volium/prelude/prelude.kicad_pcb

## KiCad design prelude.kicad_pcb (2019-05-13)

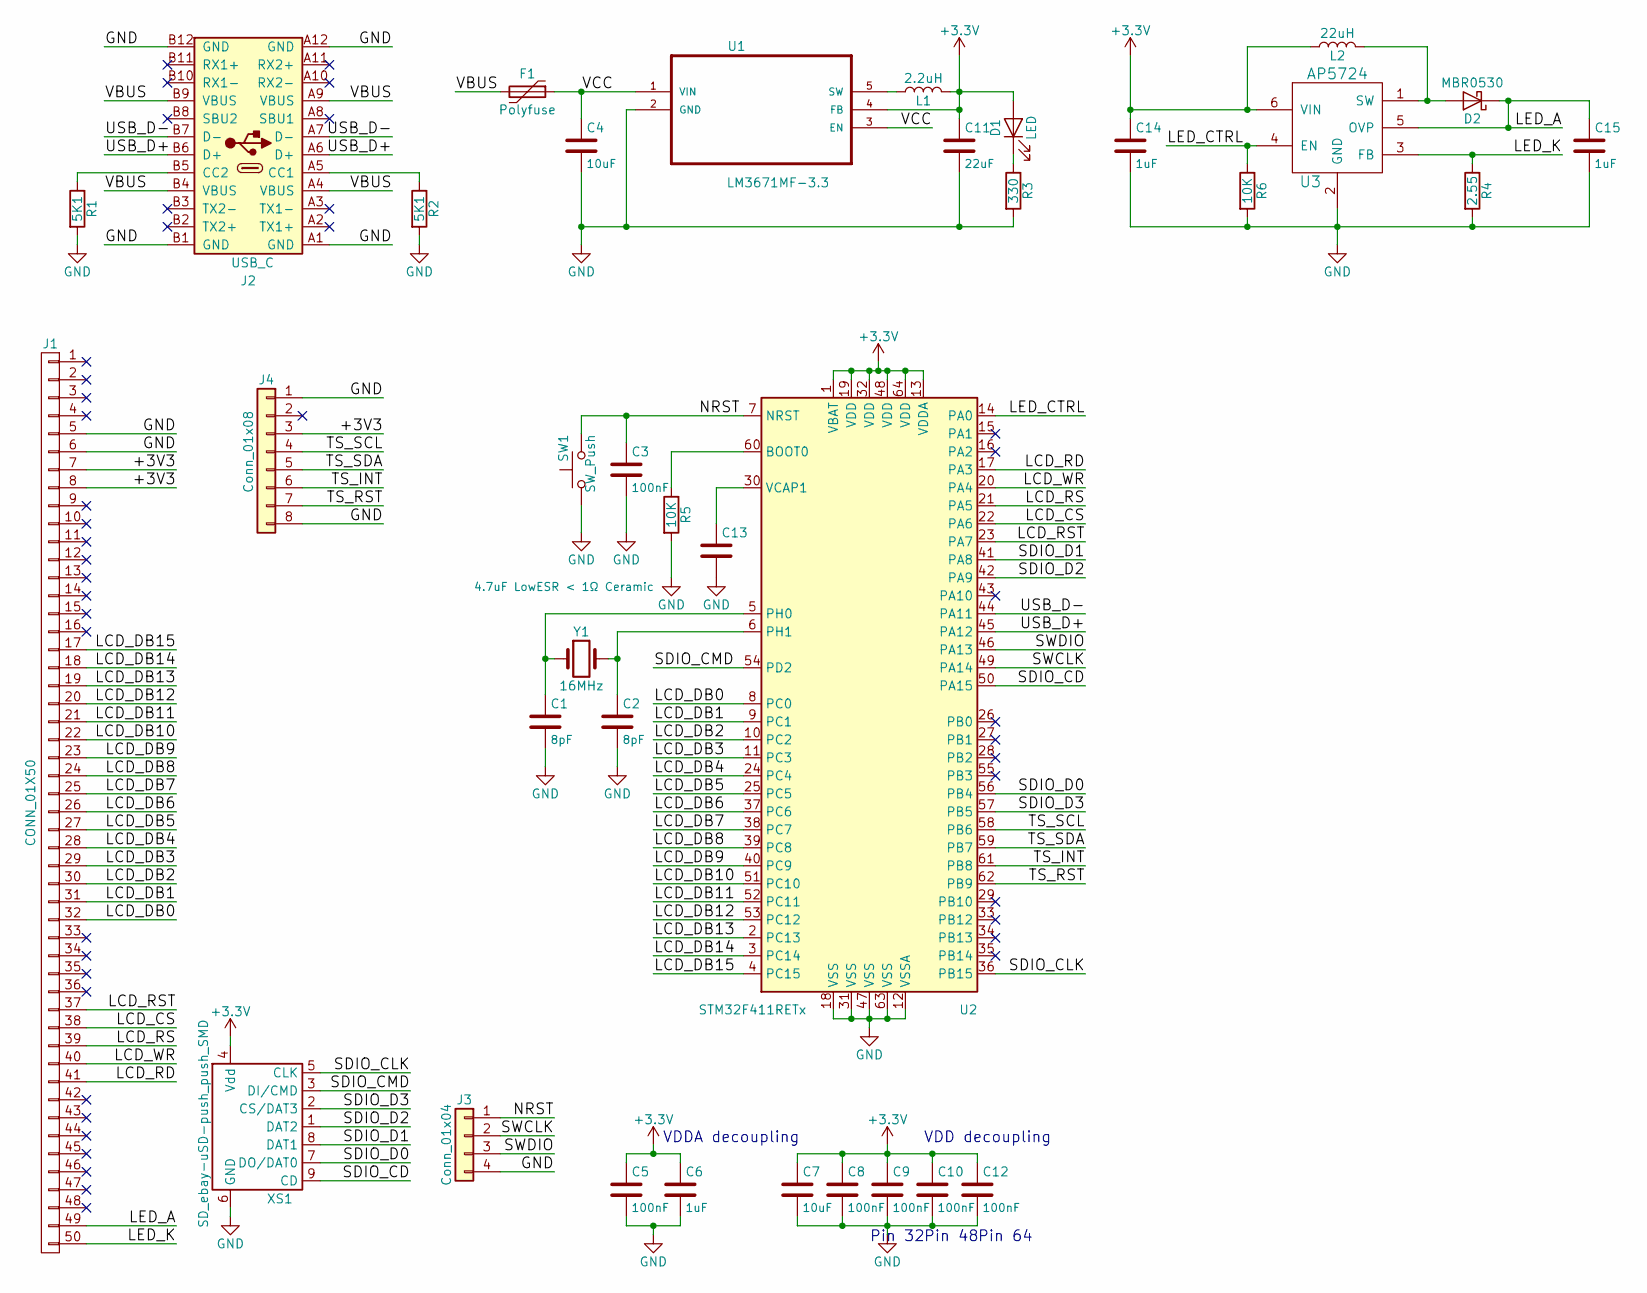
[picture p1: schematic prelude.sch]

Parts:
C1, C2: 8pF; C_0805_2012Metric
C3, C5, C8, C9, C10, C12: 100nF; C_0805_2012Metric
C4, C7: 10uF; C_0805_2012Metric
C6, C14, C15: 1uF; C_0805_2012Metric
C11: 22uF; C_0805_2012Metric
C13: 4.7uF LowESR < 1Ω Ceramic; C_0805_2012Metric
D1: LED; LED_0805_2012Metric
D2: MBR0530; D_SOD-123
F1: Polyfuse; MF-PSMF050X
J1: CONN_01X50; 62684-502100ALF
J2: USB_C; D0-9062-005LG
J3: Conn_01x04; M20-8890445
J4: Conn_01x08; WE_68710814022
L1: 2.2uH; L_Taiyo-Yuden_NR-24xx_HandSoldering
L2: 22uH; L_Taiyo-Yuden_NR-30xx_HandSoldering
R1, R2: 5K1; R_0805_2012Metric
R3: 330; R_0805_2012Metric
R4: 2.55; R_0805_2012Metric
R5, R6: 10K; R_0805_2012Metric
SW1: SW_Push; SW_SPST_PTS645
U1: LM3671MF-3.3; SOT-23-5_HandSoldering
U2: STM32F411RETx; LQFP-64_10x10mm_P0.5mm
U3: AP5724; SOT-23-6_Handsoldering
XS1: SD_ebay-uSD-push_push_SMD; Conn_uSDcard
Y1: 16MHz; Crystal_SMD_5032-2Pin_5.0x3.2mm

Connections:
/LCD_CS: J1.38, U2.22 (PA6)
/LCD_DB0: J1.32, U2.8 (PC0)
/LCD_DB1: J1.31, U2.9 (PC1)
/LCD_DB2: J1.30, U2.10 (PC2)
/LCD_DB3: J1.29, U2.11 (PC3)
/LCD_DB4: J1.28, U2.24 (PC4)
/LCD_DB5: J1.27, U2.25 (PC5)
/LCD_DB6: J1.26, U2.37 (PC6)
/LCD_DB7: J1.25, U2.38 (PC7)
/LCD_DB8: J1.24, U2.39 (PC8)
/LCD_DB9: J1.23, U2.40 (PC9)
/LCD_DB10: J1.22, U2.51 (PC10)
/LCD_DB11: J1.21, U2.52 (PC11)
/LCD_DB12: J1.20, U2.53 (PC12)
/LCD_DB13: J1.19, U2.2 (PC13)
/LCD_DB14: J1.18, U2.3 (PC14)
/LCD_DB15: J1.17, U2.4 (PC15)
/LCD_RD: J1.41, U2.17 (PA3)
/LCD_RS: J1.39, U2.21 (PA5)
/LCD_RST: J1.37, U2.23 (PA7)
/LCD_WR: J1.40, U2.20 (PA4)
/LED_A: C15.1, D2.1 (K), J1.49, U3.5 (OVP)
/LED_CTRL: R6.1, U2.14 (PA0), U3.4 (EN)
/LED_K: J1.50, R4.1, U3.3 (FB)
/NRST: C3.1, J3.1, SW1.2, U2.7 (NRST)
/SDIO_CD: U2.50 (PA15), XS1.9 (CD)
/SDIO_CLK: U2.36 (PB15), XS1.5 (CLK)
/SDIO_CMD: U2.54 (PD2), XS1.3 (DI/CMD)
/SDIO_D0: U2.56 (PB4), XS1.7 (DO/DAT0)
/SDIO_D1: U2.41 (PA8), XS1.8 (DAT1)
/SDIO_D2: U2.42 (PA9), XS1.1 (DAT2)
/SDIO_D3: U2.57 (PB5), XS1.2 (CS/DAT3)
/SWCLK: J3.2, U2.49 (PA14)
/SWDIO: J3.3, U2.46 (PA13)
/TS_INT: J4.6, U2.61 (PB8)
/TS_RST: J4.7, U2.62 (PB9)
/TS_SCL: J4.4, U2.58 (PB6)
/TS_SDA: J4.5, U2.59 (PB7)
/USB_D+: J2.A6 (D+), J2.B6 (D+), U2.45 (PA12)
/USB_D-: J2.A7 (D-), J2.B7 (D-), U2.44 (PA11)
/VBUS: F1.2, J2.A4 (VBUS), J2.A9 (VBUS), J2.B4 (VBUS), J2.B9 (VBUS)
/VCC: C4.1, F1.1, U1.1 (VIN), U1.3 (EN)
GND: C1.2, C2.2, C3.2, C4.2, C5.2, C6.2, C7.2, C8.2, C9.2, C10.2, C11.2, C12.2, C13.2, C14.2, C15.2, J1.5, J1.6, J2.A1 (GND), J2.A12 (GND), J2.B1 (GND), J2.B12 (GND), J3.4, J4.1, J4.8, R1.2, R2.2, R3.2, R4.2, R5.2, R6.2, SW1.1, U1.2 (GND), U2.12 (VSSA), U2.18 (VSS), U2.31 (VSS), U2.47 (VSS), U2.63 (VSS), U3.2 (GND), XS1.6 (GND)
unnamed: C1.1, U2.5 (PH0), Y1.1
unnamed: C2.1, U2.6 (PH1), Y1.2
unnamed: C13.1, U2.30 (VCAP1)
unnamed: D1.1 (K), R3.1
unnamed: D2.2 (A), L2.2, U3.1 (SW)
unnamed: J2.A5 (CC1), R2.1
unnamed: J2.B5 (CC2), R1.1
unnamed: L1.1, U1.5 (SW)
unnamed: R5.1, U2.60 (BOOT0)

Notes on the sheet:
VDDA decoupling
VDD decoupling
Pin 64
Pin 48
Pin 32

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
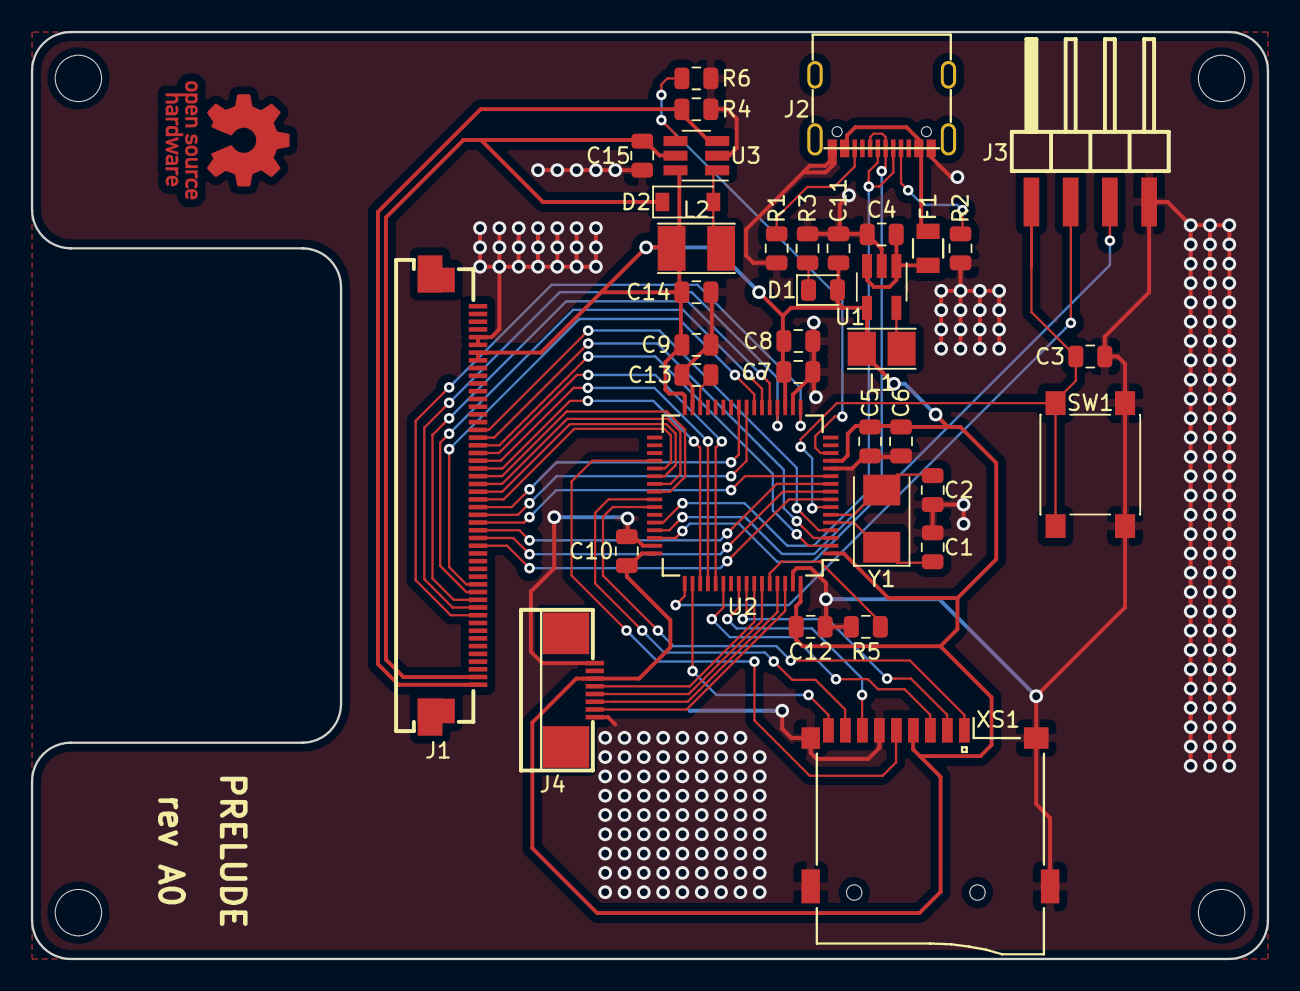
[picture p2: board prelude.kicad_pcb from above]

Board: 2 copper layers, 80.0 x 60.0 mm, 36 parts (0 on the bottom side), 53 nets.
