volium/prelude/(commit log)

2017-08-16 First commit
    Adding project files for prelude
    [prelude.kicad_pcb, prelude.sch]
2017-08-16 Adds MCU and 50 pin connector to schematic
    Adds STM32F103RETx to schematic
    Adds STM32 library to project
    [prelude.sch]
2017-08-19 Adds main 3.3 power supply based on LM3671MF
    Removed and added back 50-in connector, after fixing grid alignment
    [prelude.sch]
2017-08-23 Updates USB connector to to USB C
    Added necessary connections and resistors (5.1K pulldown) to allow for device enumeration
    [prelude.sch]
2017-08-23 Updates schematic and project
    Adds passives and wires to MCU
    Adds switches library to project
    [prelude.sch]
2017-09-01 Several updates to schematic
    Adds decoupling capacitors
    Adds debug connector
    Adds values to several components
    [prelude.sch]
2017-09-01 Adds values to Crystal (16 MHz) and a one inductor (2.2 uH)
    [prelude.sch]
2017-09-01 Annotates components
    [prelude.sch]
2017-09-04 Several changes
    Ran CvPcb
    Added MicroSD card connector (Molex)
    Started PCB routing with MCU pin row pins 1-16 facing 50-pin LCD connector
    [prelude.kicad_pcb, prelude.sch]
2017-09-06 Moved to STM32F411RE
    Had to move to different MCU (STM32F411RE) because I2C bus was fixed to pins on B bus, which was used for LCD data bus, and SDIO was also fixed to C bus.
    Remapped LCD data bus to C bus since it allows having all other functionality (SDIO, I2C, USB) correctly mapped.
    Redid CvPcb and net generation.
    Started PCB routing with MCU pins 49-64 facing LCD connector.
    [prelude.kicad_pcb, prelude.sch]
2018-04-01 A lot of changes, just need to add more polish and clean up
    [prelude.kicad_pcb, prelude.sch]
2019-02-23 Updates project after loading with KiCad 5.0.2
    Replaced schematic symbols and pcb footprints with new versions
    Regenerated netlist after all changes
    [prelude.sch]
2019-02-27 Replaces passive components with regular (non-HandSolder) versions
    [prelude.sch]
2019-02-27 Replaces J2 Connector (USB-C) with new D0-9062-005LG (SMD 16 terminals)
    [prelude.sch]
2019-02-27 Updates prelude.kicad_pcb in latest version of KiCad (5.0.2)
    Replaced two tracks with one
    [prelude.kicad_pcb]
2019-02-27 Updates to prelude.kicad_pcb
    Reloaded updated netlist, exchanged footprints, adjusted J2 connector and rerouted USB-C portion.
    Adds R6, which had not been imported before (by mistake)
    [prelude.kicad_pcb]
2019-04-07 Fixes some routing issues
    One pwr track was too narrow
    Aligned vias for SDIO signals CMD, D0 and D3
    [prelude.kicad_pcb]
2019-04-09 Final touches to prelude
    Added via stitching, fixed alignment issues, moved references in silkscreen, added OSH logo and project name and revision
    Updates main prelude.pro project file
    [prelude.kicad_pcb]
2019-04-09 Adds more via stitching at the top of the board
    [prelude.kicad_pcb]
2019-04-09 Adds project name and revision to back silk screen
    [prelude.kicad_pcb]
2019-04-12 Adds gerber files, including zip file
    [prelude-B_Mask.gbs, prelude-B_SilkS.gbo, prelude-Bottom.gbl, prelude-Edge_Cuts.gm1, prelude-F_Mask.gts, prelude-F_SilkS.gto, prelude-Top.gtl, prelude.drl]
2019-04-14 Minor update to schematic to include "F" in all values of capacitors
    [prelude.sch]
2019-04-14 Regenerates netlist based on previous change to schematic
2019-04-14 Updates layout after importing latest netlist with changes in schematic.
    Moved LED_A trace to be more like LED_K on its way to J1, recalculates fill zones.
    [prelude.kicad_pcb]
2019-04-14 Adds new BOM files generated via "bom_csv_grouped_by_value"
    [prelude.csv]
2019-04-17 Minor clean up of tracks
    [prelude.kicad_pcb]
2019-04-28 Replaces Inductors (L1 and L2) with HandSoldering versions
    [prelude.sch]
2019-04-28 Replaces inductors with HandSoldering versions, recalculated fills, still need to adjust vias
    [prelude.kicad_pcb]
2019-04-28 Adjusted vias and tracks with latest Inductor footprints (HandSoldering), removed row of vias
    [prelude.kicad_pcb]
2019-04-28 Fixes via next to C10
    [prelude.kicad_pcb]
2019-05-13 Properly rounds cutout corners based on SWARM project
    [prelude.kicad_pcb]
